AleReb/domo/dataloggerDomo/domoLogger.brd

## EAGLE design dataloggerDomo/domoLogger.brd (2026-01-26)

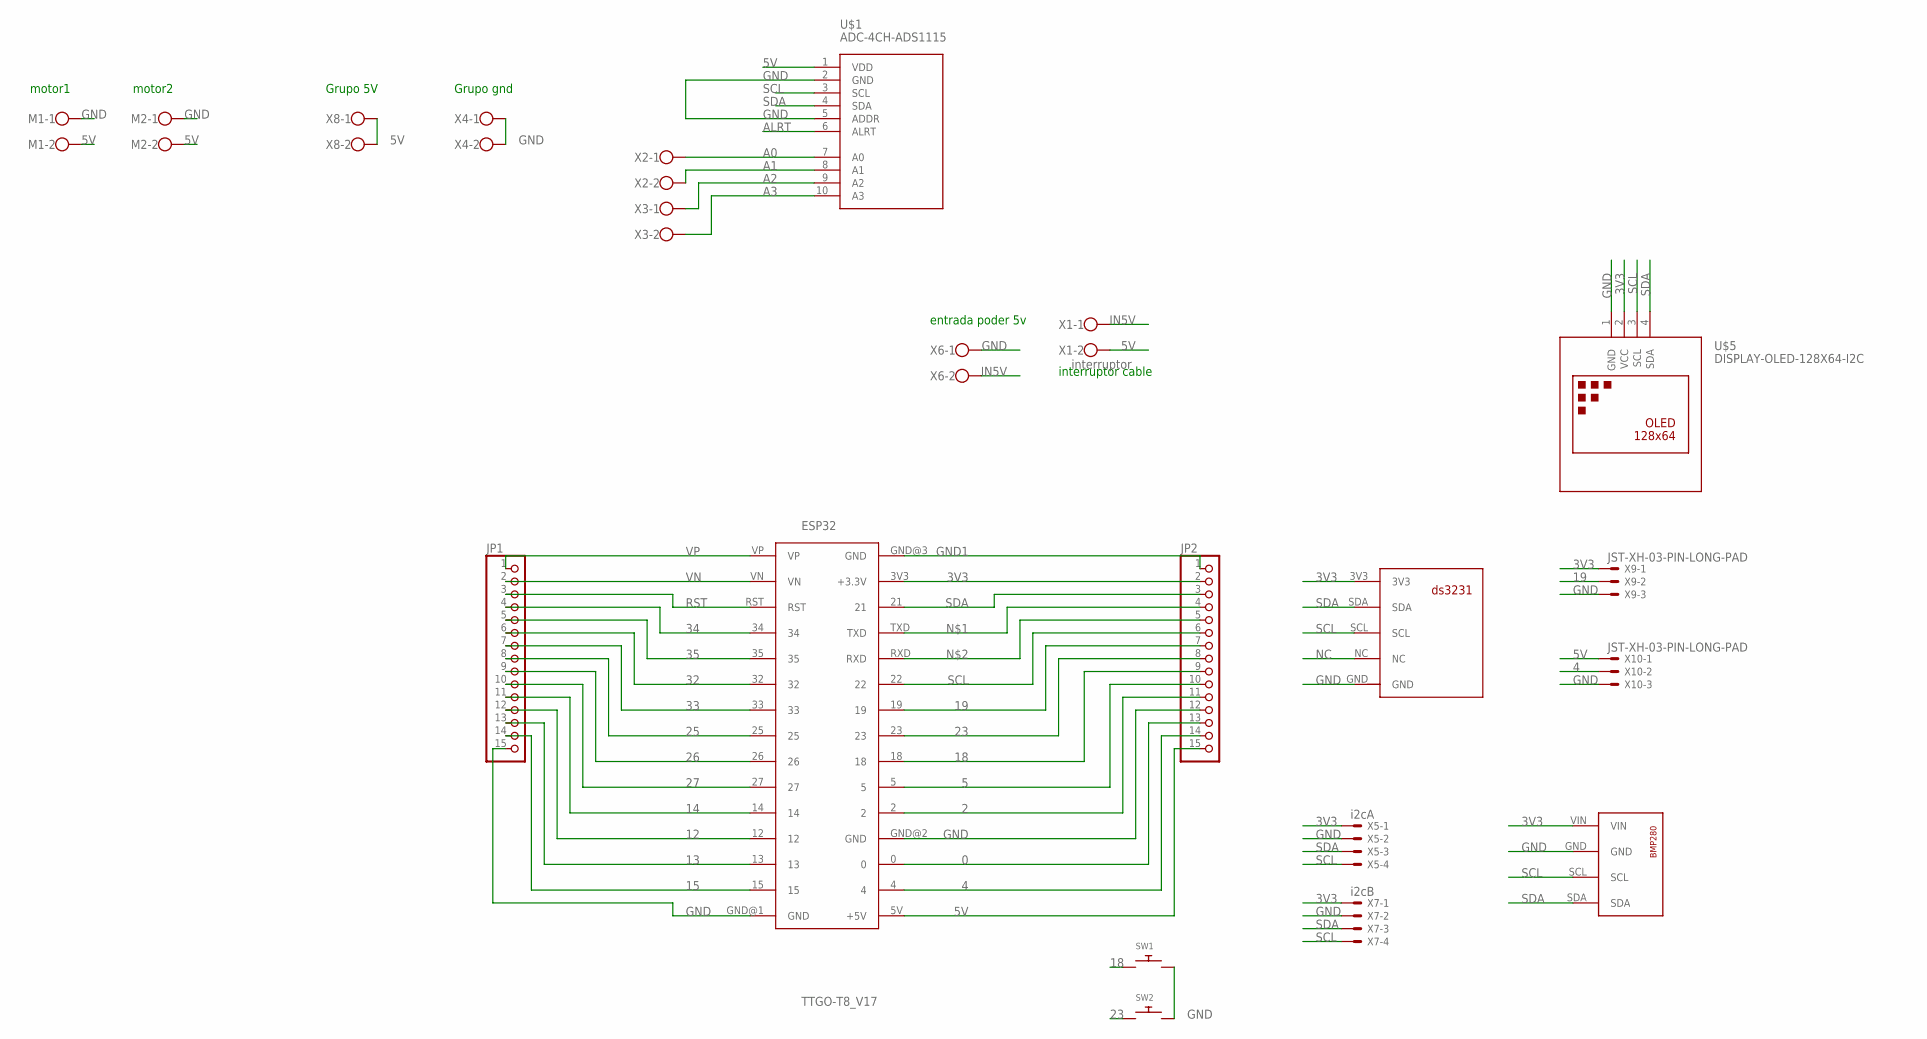
[picture p1: schematic domoLogger.sch]

Parts:
ESP32: TTGO-T8_V17
JP1, JP2: PINHD-1X15; 1X15
M1, M2: W237-102
SW1, SW2: SWITCH_PUSHBUTTONEVQ-PE; TACT_PANA-EVQ
U$1: ADC-4CH-ADS1115
U$3: GYBMEP_BMP280THROUGH_THE_HOLE; GYBMEP_BMP280
U$4: RTC; RTCDS3231FP
U$5: DISPLAY-OLED-128X64-I2C
X1: interruptor; W237-102
X2, X3, X4, X6, X8: W237-102
X5: i2cA; JST-XH-04-PACKAGE-LONG-PAD
X7: i2cB; JST-XH-04-PACKAGE-LONG-PAD
X9, X10: JST-XH-03-PIN-LONG-PAD; JST-XH-03-PACKAGE-LONG-PAD

Connections:
0: ESP32.0, JP2.13
2: ESP32.2, JP2.11
3V3: ESP32.3V3 (+3.3V), JP2.2, U$3.VIN, U$4.3V3, U$5.2 (VCC), X5.1, X7.1, X9.1
4: ESP32.4, JP2.14, X10.2
5: ESP32.5, JP2.10
5V: ESP32.5V (+5V), JP2.15, M1.2, M2.2, U$1.1 (VDD), X1.2, X8.1, X8.2, X10.1
12: ESP32.12, JP1.12
13: ESP32.13, JP1.13
14: ESP32.14, JP1.11
15: ESP32.15, JP1.14
18: ESP32.18, JP2.9, SW1.P$1
19: ESP32.19, JP2.7, X9.2
23: ESP32.23, JP2.8, SW2.P$1
25: ESP32.25, JP1.8
26: ESP32.26, JP1.9
27: ESP32.27, JP1.10
32: ESP32.32, JP1.6
33: ESP32.33, JP1.7
34: ESP32.34, JP1.4
35: ESP32.35, JP1.5
A0: U$1.7 (A0), X2.1
A1: U$1.8 (A1), X2.2
A2: U$1.9 (A2), X3.1
A3: U$1.10 (A3), X3.2
ALRT: U$1.6 (ALRT)
GND: ESP32.GND@1 (GND), ESP32.GND@2 (GND), JP1.15, JP2.12, M1.1, M2.1, SW1.P$2, SW2.P$2, U$1.2 (GND), U$1.5 (ADDR), U$3.GND, U$4.GND, U$5.1 (GND), X4.1, X4.2, X5.2, X6.1, X7.2, X9.3, X10.3
GND1: ESP32.GND@3 (GND), JP2.1
IN5V: X1.1, X6.2
unnamed: ESP32.TXD, JP2.4
unnamed: ESP32.RXD, JP2.5
NC: U$4.NC
RST: ESP32.RST, JP1.3
SCL: ESP32.22, JP2.6, U$1.3 (SCL), U$3.SCL, U$4.SCL, U$5.3 (SCL), X5.4, X7.4
SDA: ESP32.21, JP2.3, U$1.4 (SDA), U$3.SDA, U$4.SDA, U$5.4 (SDA), X5.3, X7.3
VN: ESP32.VN, JP1.2
VP: ESP32.VP, JP1.1

Notes on the sheet:
entrada poder 5v
interruptor cable
Grupo gnd
Grupo 5V
motor1
motor2

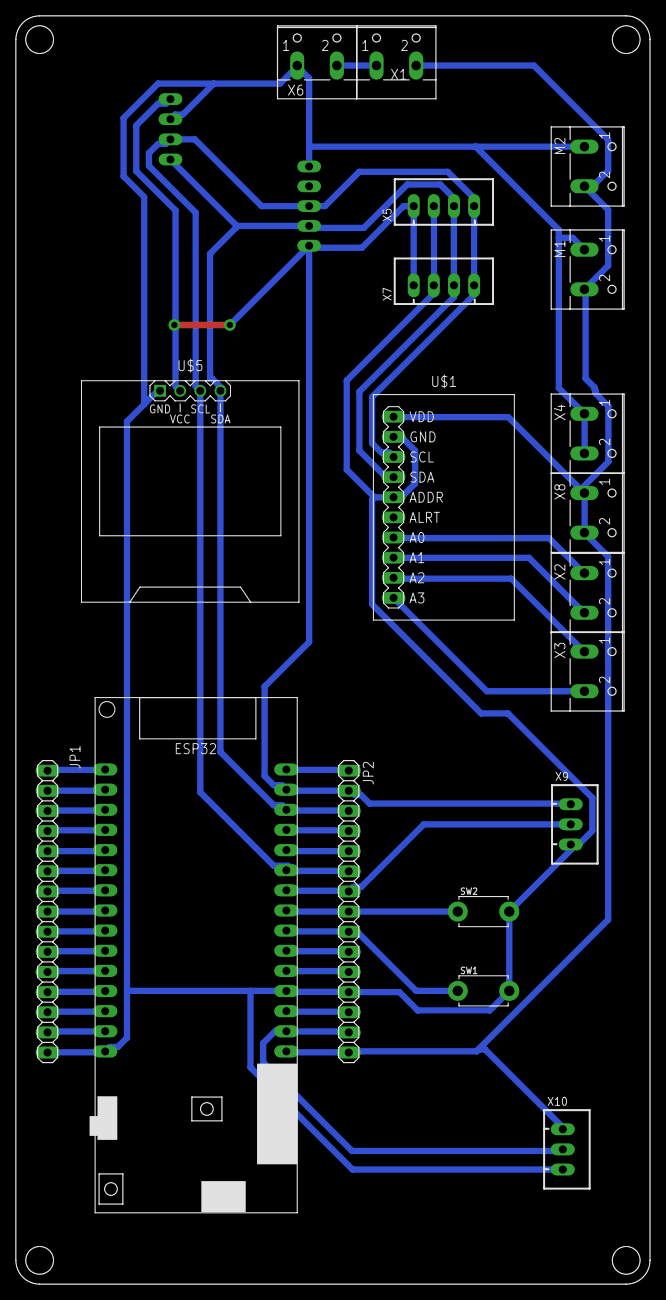
[picture p2: board domoLogger.brd from above]

Board: 2 copper layers, 80.0 x 160.0 mm, 21 parts (1 on the bottom side), 34 nets.
