AleReb/domo/build/sketch/README.md

# Documentación del proyecto

Este directorio contiene artefactos de una compilación anterior.
La documentación vigente está en [README.md](../../README.md).
Consulta [LICENSE](../../LICENSE) para las licencias por componente.
