AleReb/domo/(commit log)

2026-01-19 feat: Add VS Code Arduino configuration and implement uptime display on OLED with adjusted sensor layout.
2026-01-26 feat: Add VS Code configuration files and update the main Arduino sketch. add shematic and board pcb
2026-10-29 Actualiza la documentación y licencias del proyecto Domo para el registrador ambiental basado en ESP32
    - Renombra el README a "Domo — registrador ambiental para ESP32" y amplía la descripción del proyecto.
    - Agrega detalles sobre los componentes utilizados y sus configuraciones.
    - Mejora las instrucciones de conexión y compilación.
    - Cambia el formato del archivo CSV y detalla su contenido.
    - Añade un archivo LICENSE en el directorio dataloggerDomo para los diseños de hardware bajo CERN-OHL-S-2.0.
    - Incluye encabezados de licencia en el archivo de firmware `domo.ino`.
